LeoLHsu/Xenon_Lamp/Doc/Device/推杆.jpg

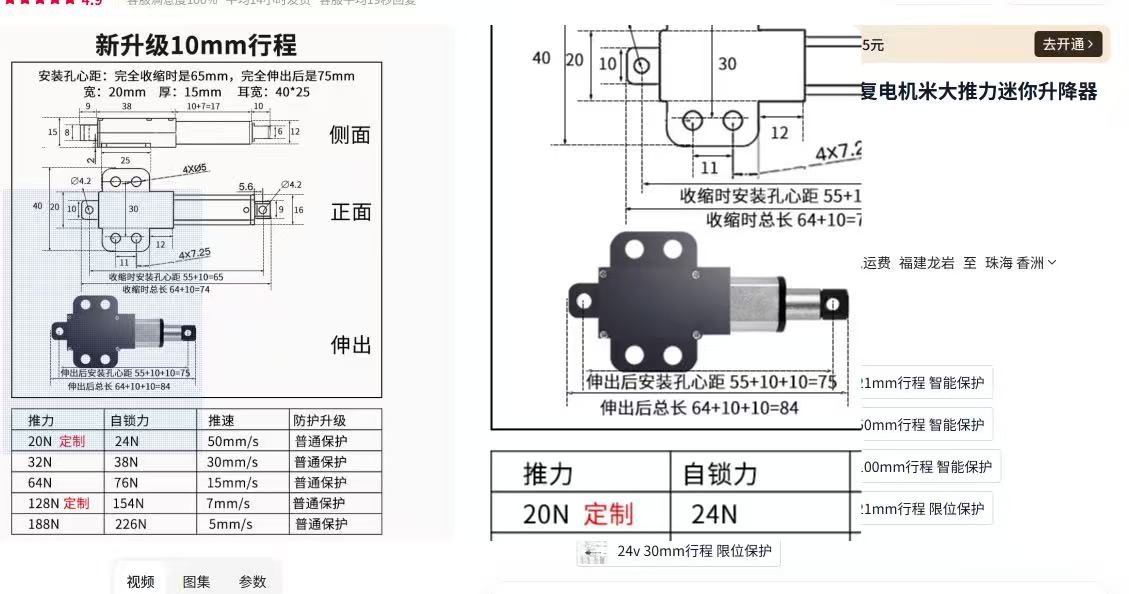
Doc/Device/推杆.jpg
