LeoLHsu/Xenon_Lamp/Doc/氙灯电源板功能描述.docx

功能描述：

1. 根据上位机的命令控制氙灯上电（LAMP_EN管脚，高有效）
2. 上电前需将电流设定调为最大10A（最大12A）,(重要，否则无法点亮氙灯)，点亮后再调低电流至目标亮度。
3. 电流设定信号为Current_SET管脚，MCU_DAC输出， Current_OUT=Current_SET/0.25
4. 电流检测信号为Current_DET管脚，MCU_DAC输入，

Current_DET=Current*0.25

5. 氙灯电压检测：Lamp_DET= Lamp_PWR/101

enable后，电压输出为150V.如电压持续10s不下降，则关闭电压输出，并报错：

1） 无电流输出，报错：触发器故障/输出空载
2） 有脉冲电流输出，报错：氙灯损坏

如氙灯可正常触发，电压应在3s秒迅速降低至8-15V，电流稳定至10A后，再根据亮度需求调整电流值。

电压超过17V，则应报错：氙灯寿命已接近耗尽

6. 寿命统计：400报错，500h强行关闭
7. 增加NTC功能，温度超过80度报警，100度强制关闭
