LeoLHsu/Xenon_Lamp/Doc/Sch/XL100A-60-01 A0.pdf

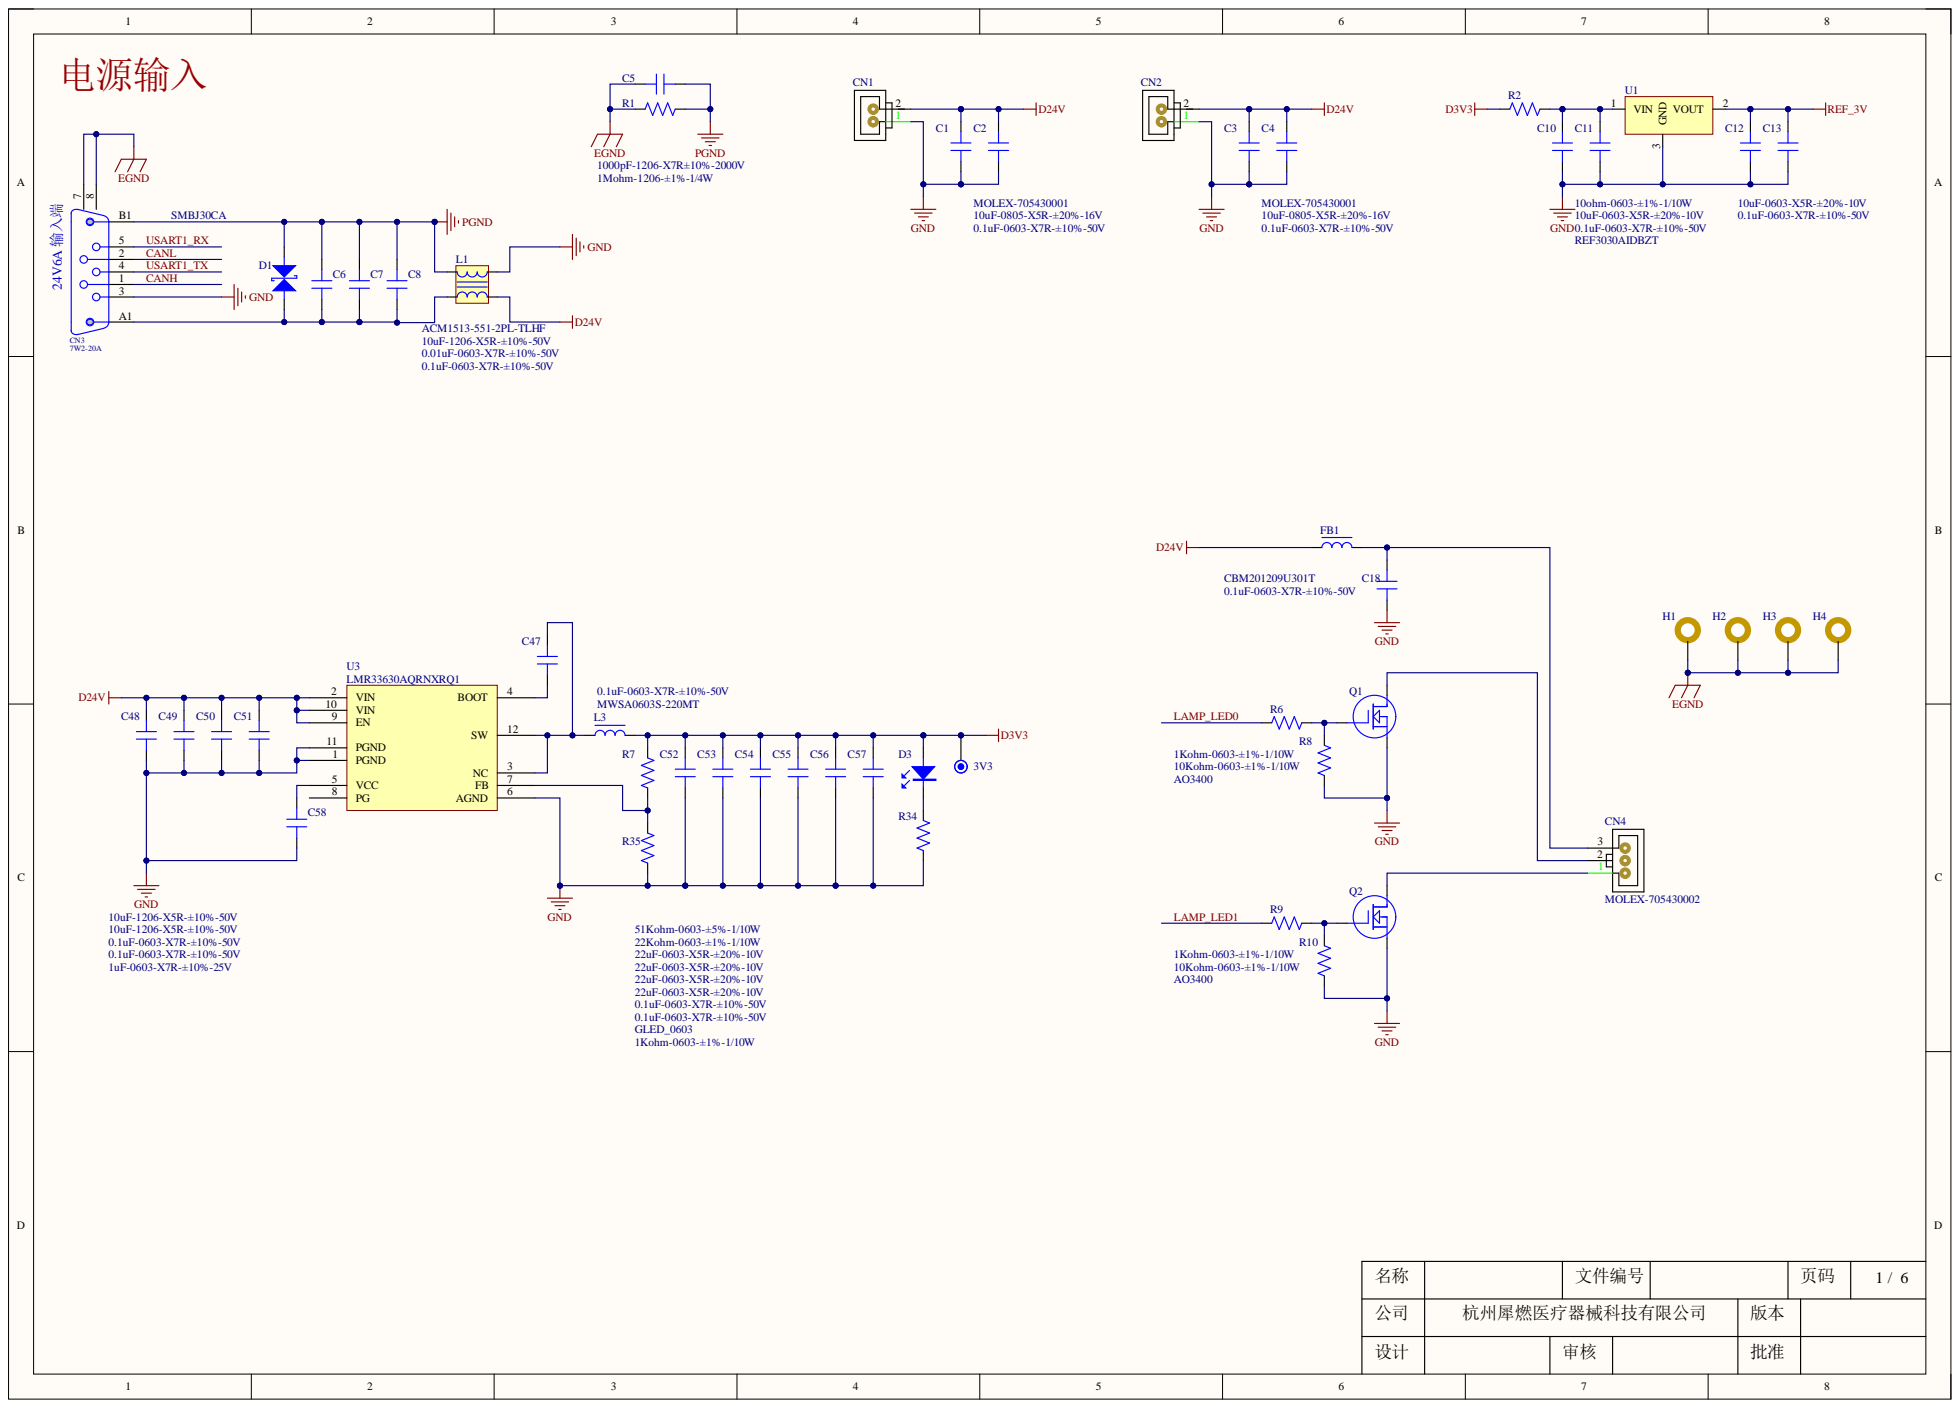
[picture p2: page 1]

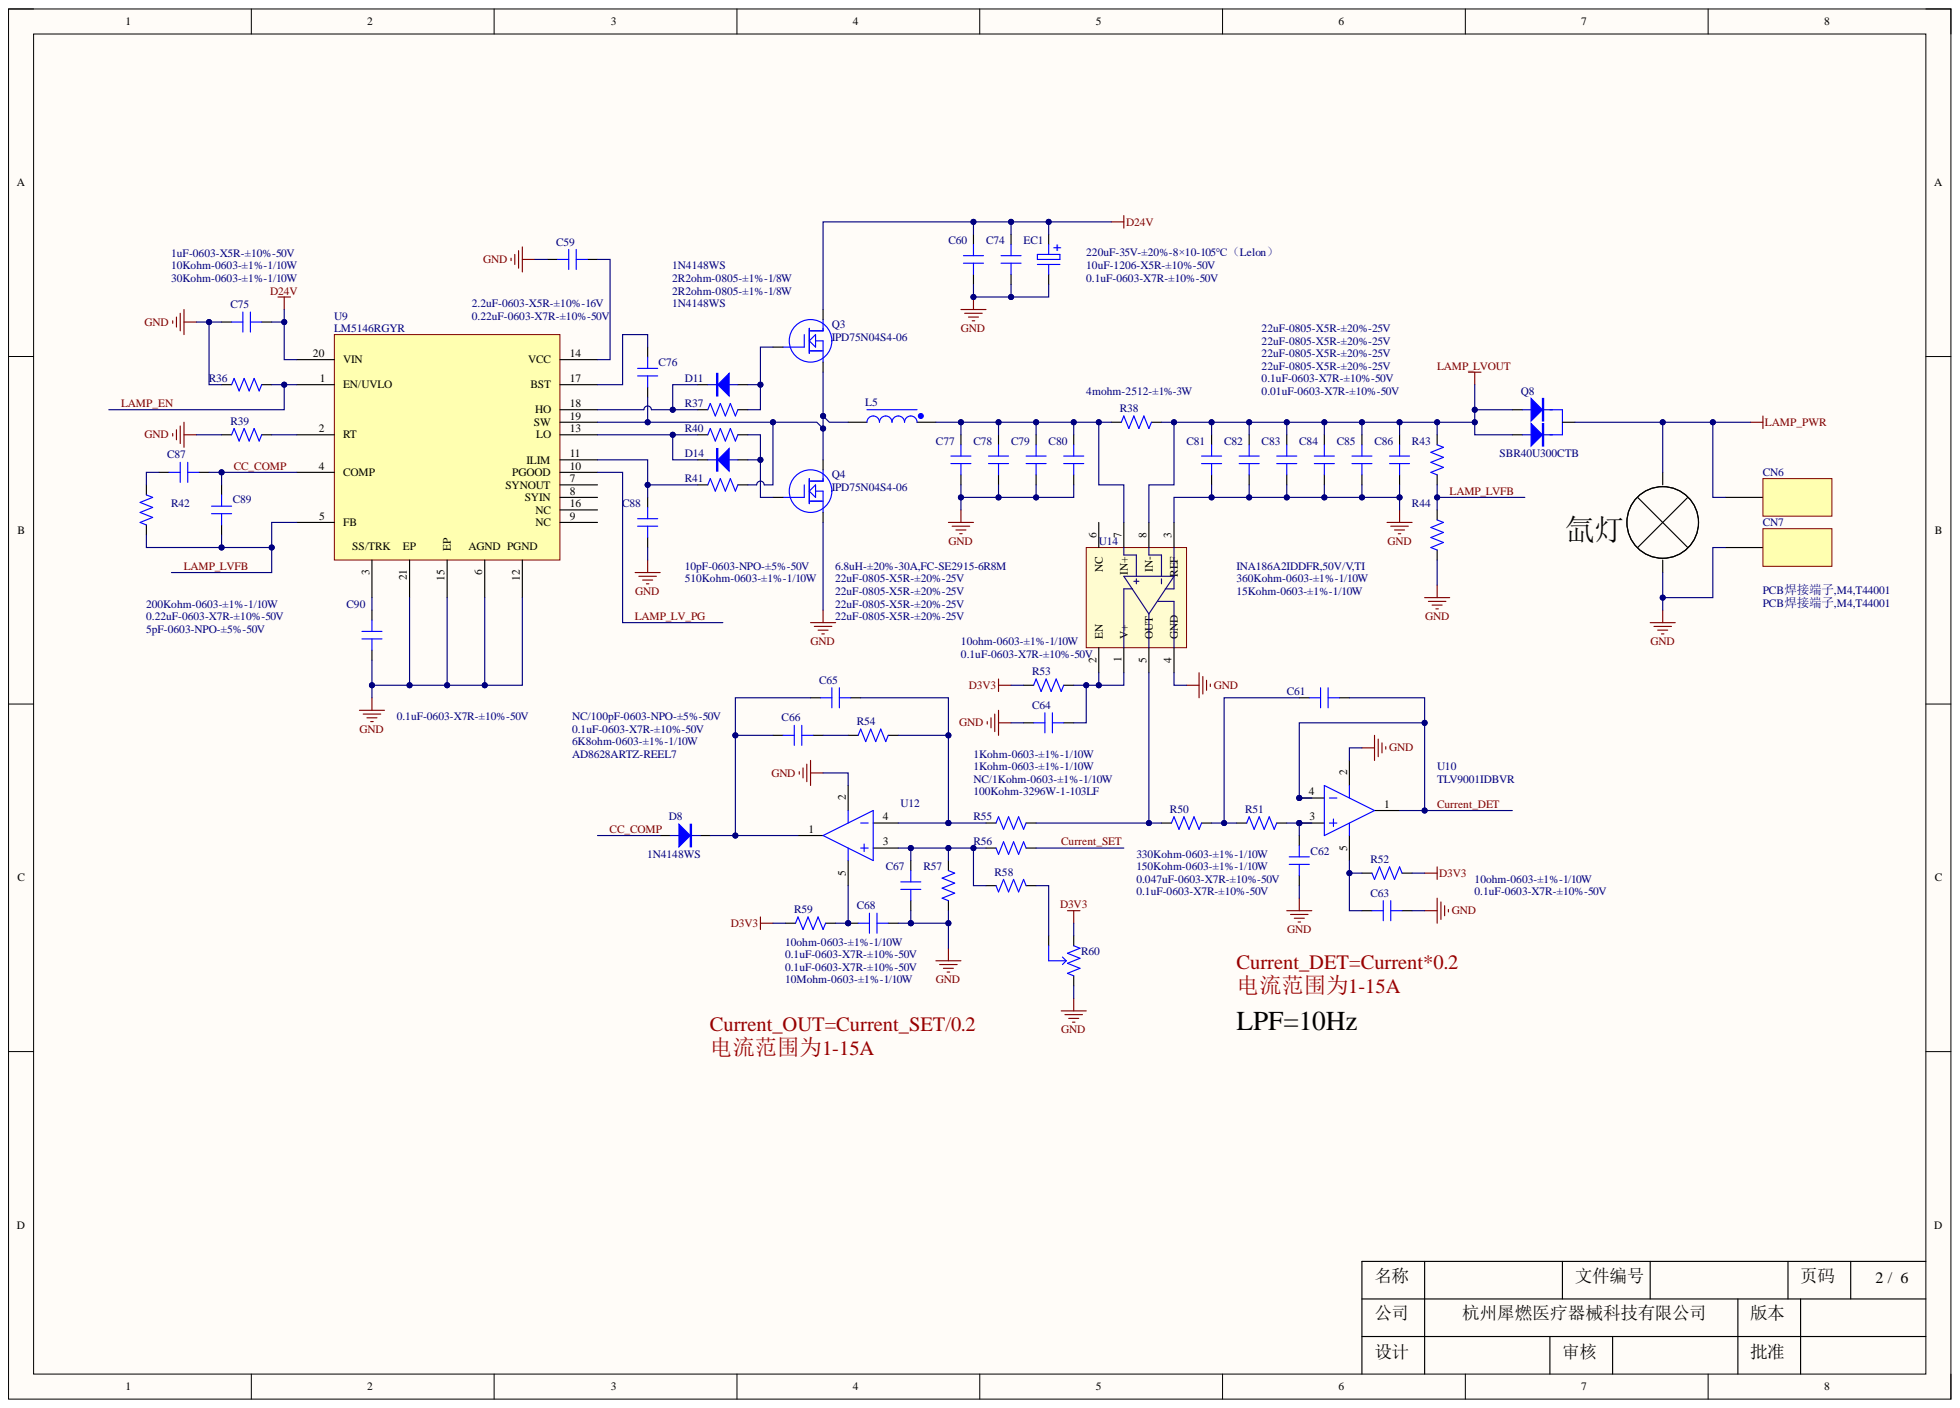
[picture p3: page 2]

7 | R41
8 | 510Kohm D

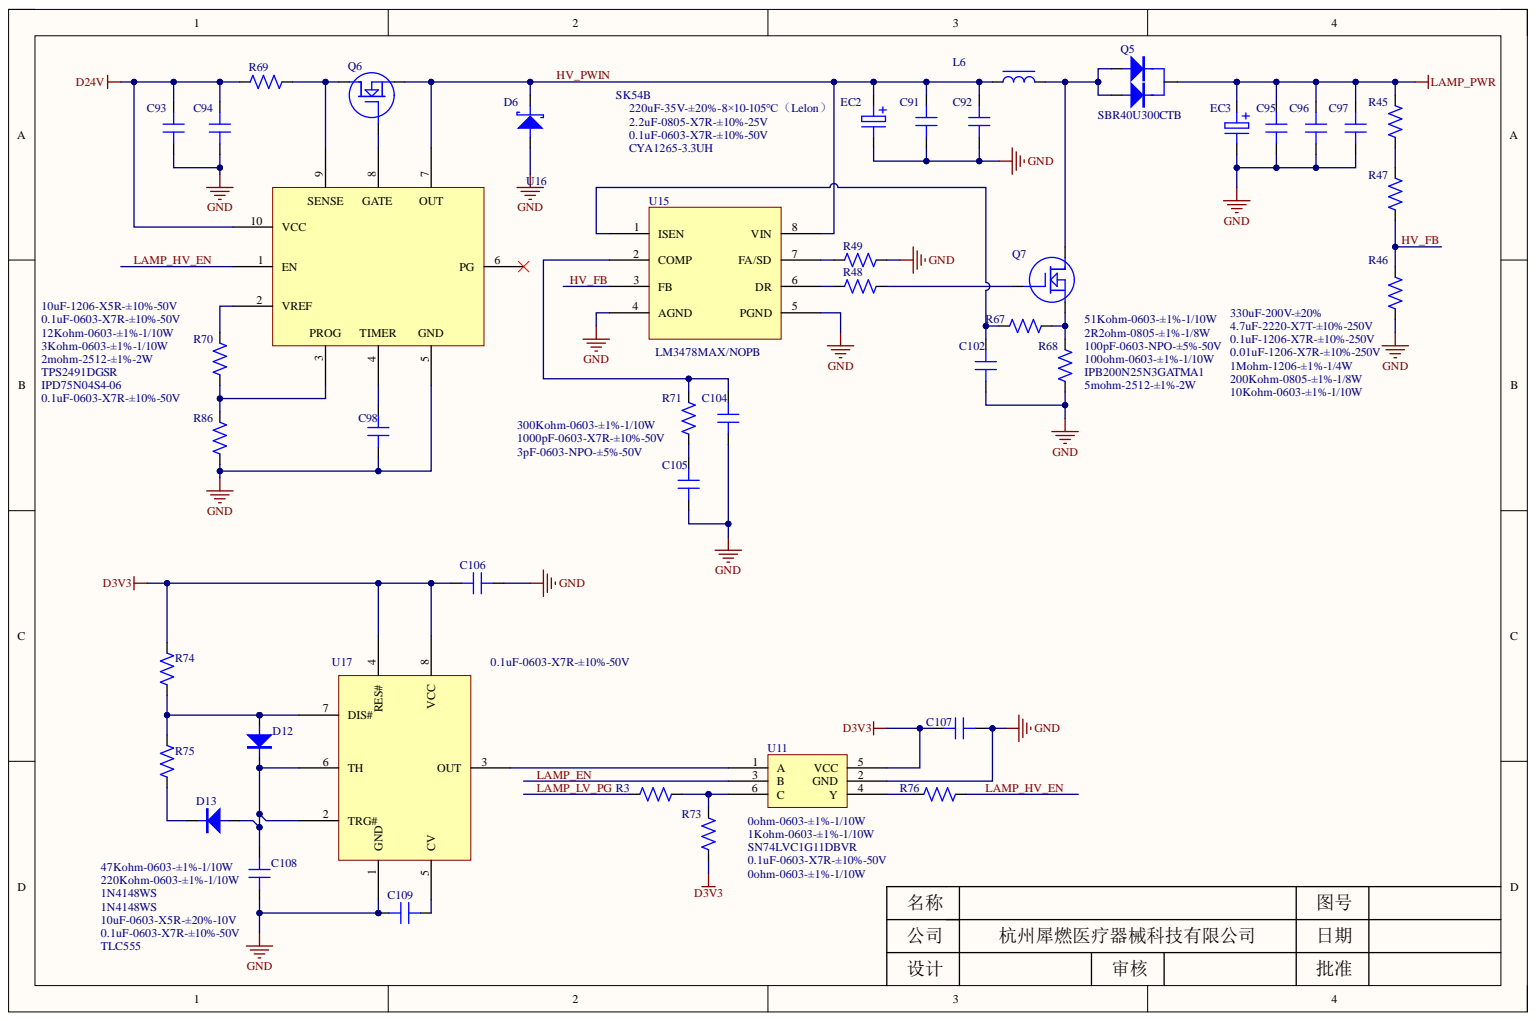
[picture p4: page 3]

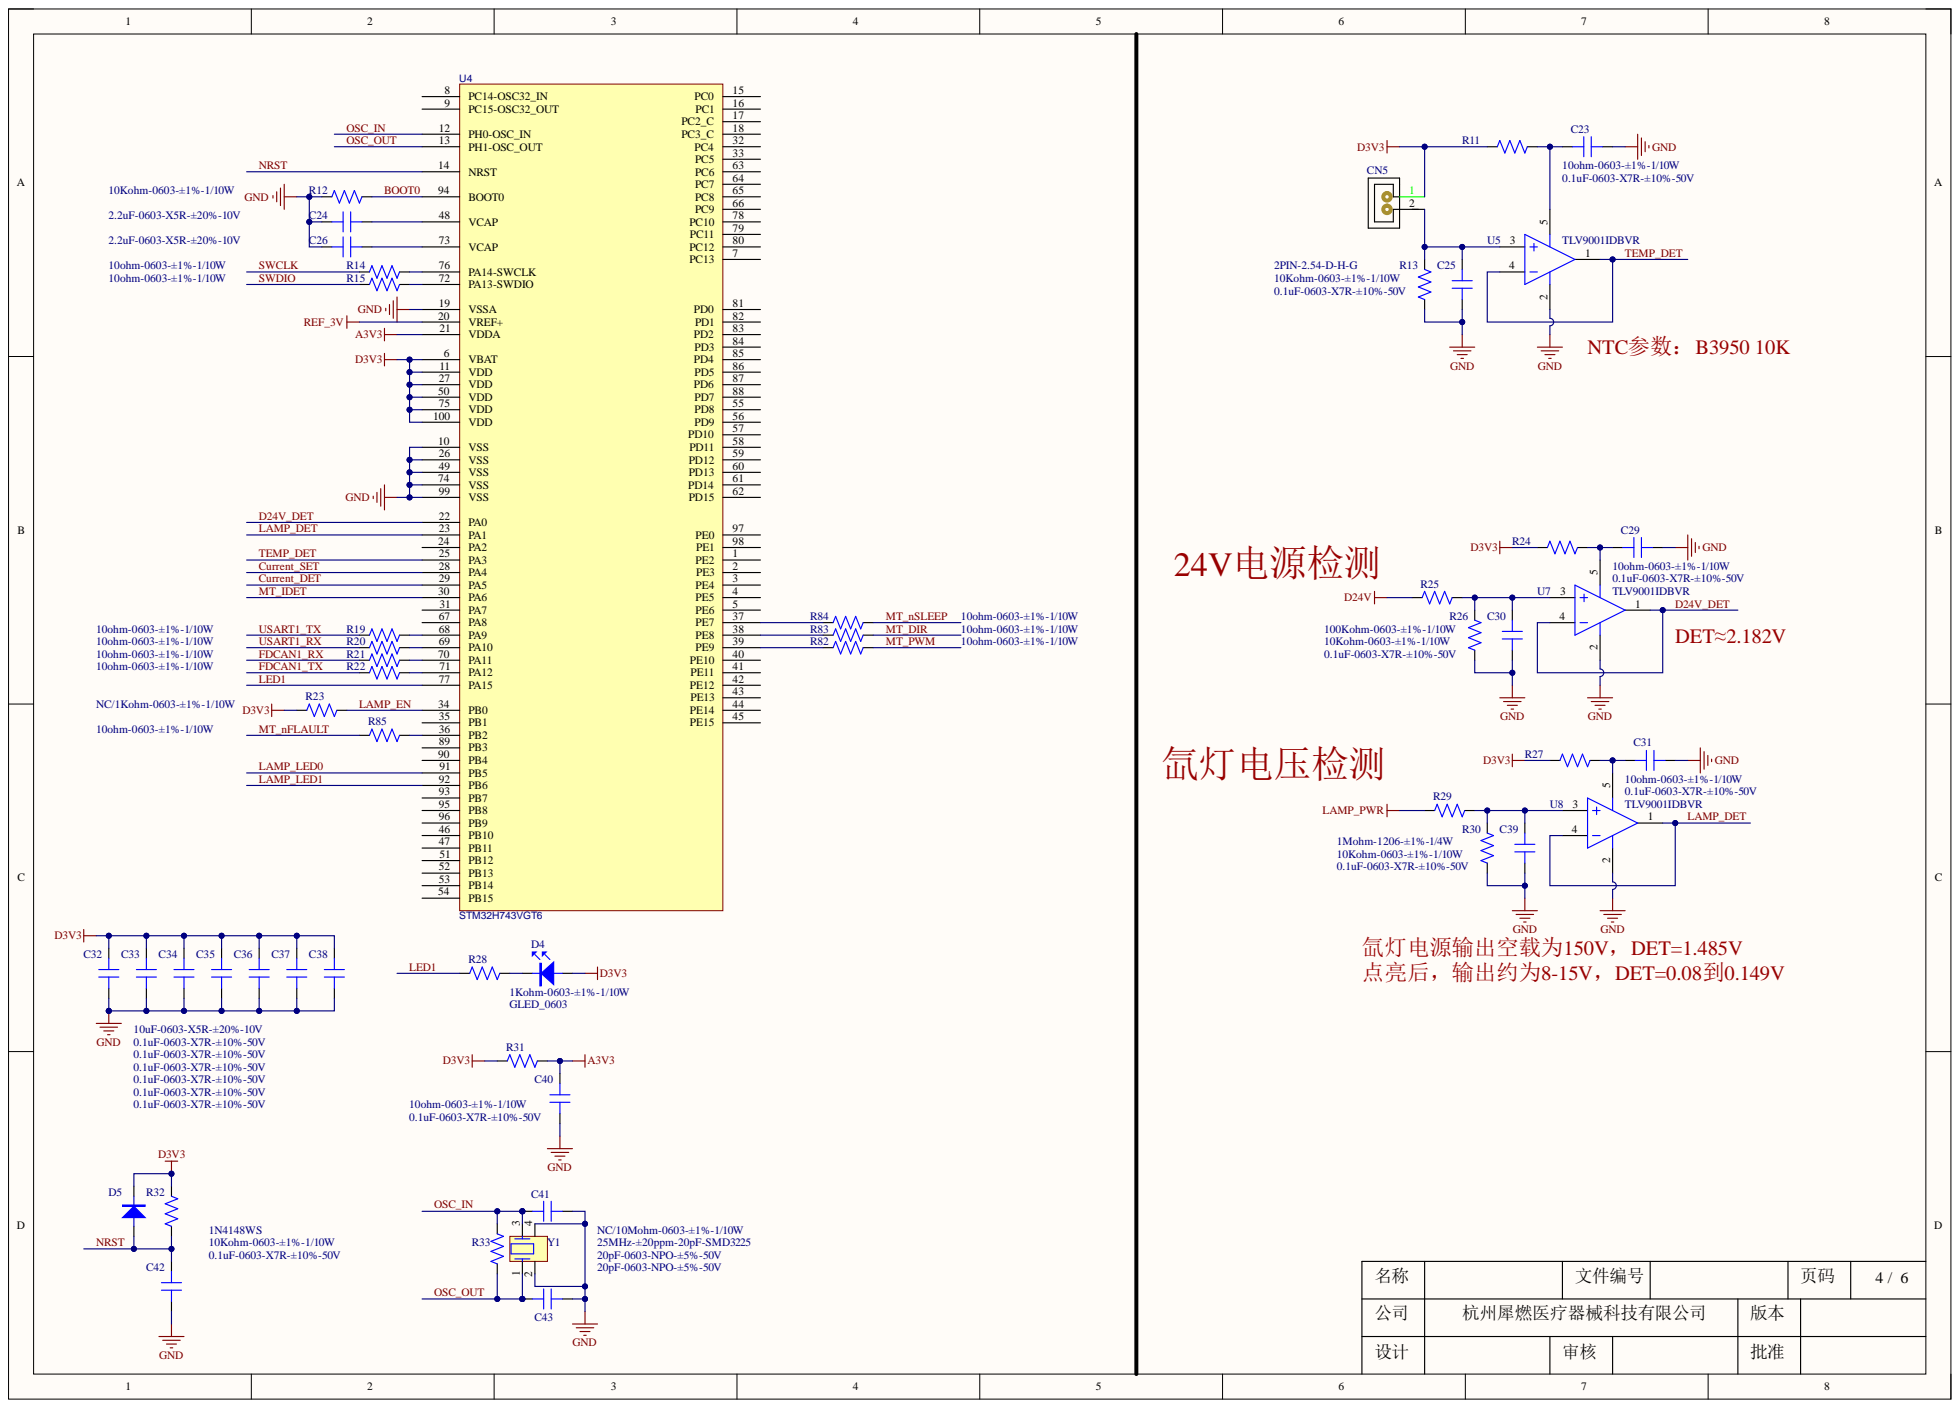
[picture p5: page 4]

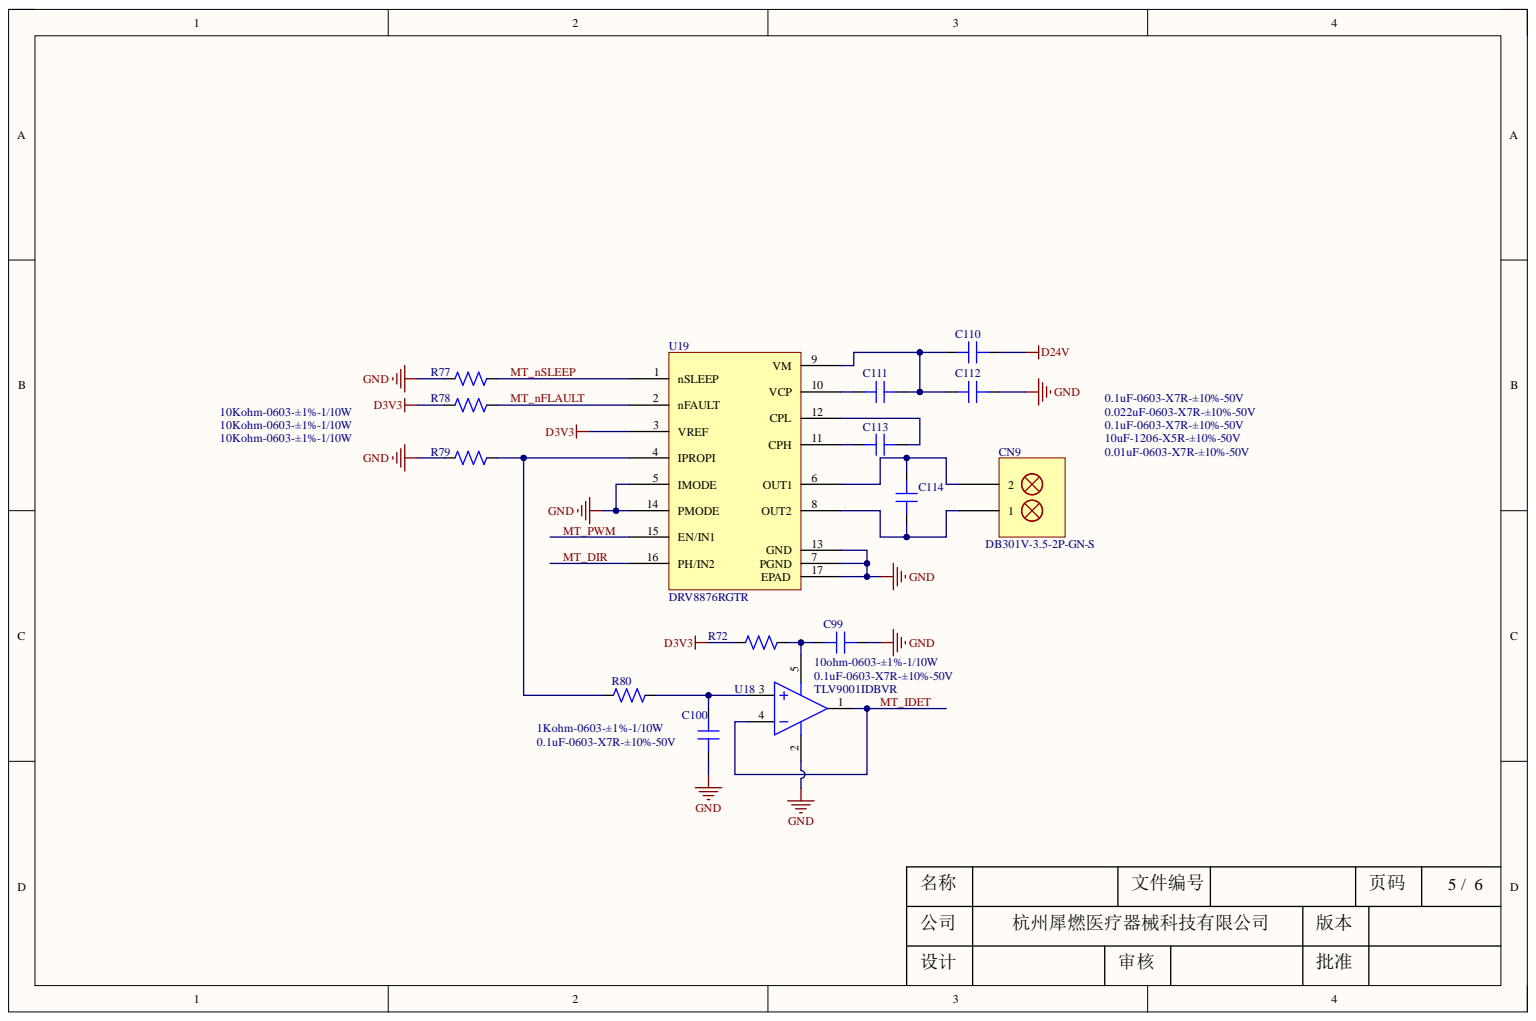
[picture p6: page 5]

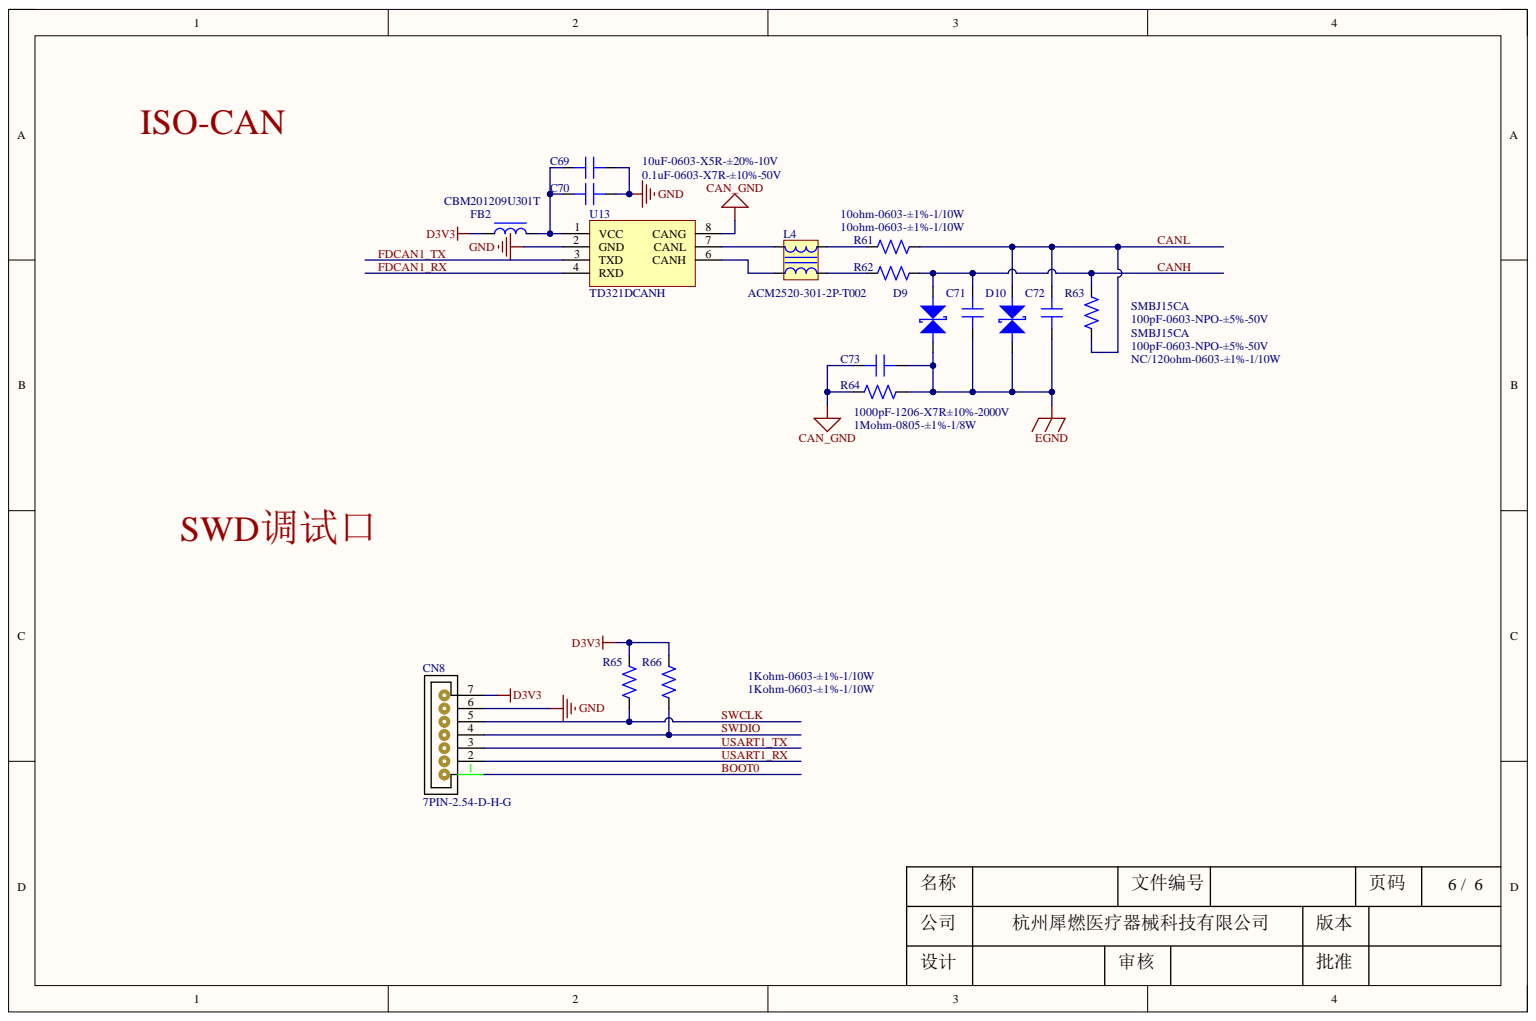
[picture p7: page 6]
