LeoLHsu/Xenon_Lamp/Core/Src/main.c

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
/* Includes ------------------------------------------------------------------*/
#include "main.h"
#include "adc.h"
#include "dac.h"
#include "dma.h"
#include "fdcan.h"
#include "iwdg.h"
#include "usart.h"
#include "gpio.h"

/* USER CODE BEGIN Includes */
#include <string.h>
#include "Can_Service.h"
#include "UserPref.h"
#include "drv8876.h"
#include "Xenon_Lamp.h"
/* USER CODE END Includes */


void SystemClock_Config(void);
void PeriphCommonClock_Config(void);
static void MPU_Config(void);
/* USER CODE BEGIN 0 */
#ifdef BOOTLOADER

/** @brief  Vector base address configuration. It should no longer be at the start of
  *         flash memory but moved forward because the first part of flash is
  *         reserved for the bootloader. Note that this is already done by the
  *         bootloader before starting this program. Unfortunately, function
  *         SystemInit() overwrites this change again.
  * @return none.
  */
static void VectorBase_Config(void)
{
    /* The constant array with vectors of the vector table is declared externally in the
     * c-startup code.
     */
    extern const unsigned long g_pfnVectors[];

    /* Remap the vector table to where the vector table is located for this program. */
    SCB->VTOR = (unsigned long)&g_pfnVectors[0];
}
#endif
/* USER CODE END 0 */

/**
  * @brief  The application entry point.
  * @retval int
  */
int main(void)
{
    /* USER CODE BEGIN 1 */
#ifdef BOOTLOADER
    /* Configure the vector table base address. */
    VectorBase_Config();
#endif
    /* USER CODE END 1 */

    /* MPU Configuration--------------------------------------------------------*/
    MPU_Config();

    /* Enable I-Cache---------------------------------------------------------*/
    SCB_EnableICache();

    /* Enable D-Cache---------------------------------------------------------*/
    SCB_EnableDCache();

    /* MCU Configuration--------------------------------------------------------*/

    /* Reset of all peripherals, Initializes the Flash interface and the Systick. */
    HAL_Init();

    /* Configure the system clock */
    SystemClock_Config();

    /* Configure the peripherals common clocks */
    PeriphCommonClock_Config();

    /* Initialize all configured peripherals */
    MX_GPIO_Init();
    MX_DMA_Init();
    MX_USART1_UART_Init();
    MX_DAC1_Init();
    MX_FDCAN1_Init();
    MX_ADC1_Init();
    MX_IWDG1_Init();
    /* USER CODE BEGIN 2 */
    SystemTimeBase_Initial();
    Debug_Initial();
    CAN_Initial();
    MainReg_Initial();
    /* USER CODE END 2 */

    /* Infinite loop */
    /* USER CODE BEGIN WHILE */
    EE_Read_Setting();
    DRV8876_Init();
    Xenon_Lamp_Initial();
    while (1) {
        /* USER CODE END WHILE */

        /* USER CODE BEGIN 3 */
        HAL_IWDG_Refresh(&hiwdg1);
        SystemTimeBase_Set_Handler();
        CAN_Handler();
        Debug_Handler();
        Adc_Handler();
        Xenon_Lamp_Service();
        EE_Setting_Handler();
        SystemTimeBase_Clr_Handler();
    }
    /* USER CODE END 3 */
}

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
/* MPU Configuration */

void MPU_Config(void)
{
    MPU_Region_InitTypeDef MPU_InitStruct = {0};

    /* Disables the MPU */
    HAL_MPU_Disable();

    /** Initializes and configures the Region and the memory to be protected
    */
    MPU_InitStruct.Enable = MPU_REGION_ENABLE;
    MPU_InitStruct.Number = MPU_REGION_NUMBER0;
    MPU_InitStruct.BaseAddress = 0x24000000;
    MPU_InitStruct.Size = MPU_REGION_SIZE_512KB;
    MPU_InitStruct.SubRegionDisable = 0x0;
    MPU_InitStruct.TypeExtField = MPU_TEX_LEVEL0;
    MPU_InitStruct.AccessPermission = MPU_REGION_FULL_ACCESS;
    MPU_InitStruct.DisableExec = MPU_INSTRUCTION_ACCESS_ENABLE;
    MPU_InitStruct.IsShareable = MPU_ACCESS_NOT_SHAREABLE;
    MPU_InitStruct.IsCacheable = MPU_ACCESS_NOT_CACHEABLE;
    MPU_InitStruct.IsBufferable = MPU_ACCESS_NOT_BUFFERABLE;

    HAL_MPU_ConfigRegion(&MPU_InitStruct);
    /* Enables the MPU */
    HAL_MPU_Enable(MPU_PRIVILEGED_DEFAULT);

}

/**
  * @brief  This function is executed in case of error occurrence.
  * @retval None
  */
void Error_Handler(void)
{
    /* USER CODE BEGIN Error_Handler_Debug */
    /* User can add his own implementation to report the HAL error return state */
    __disable_irq();
    while (1) {
    }
    /* USER CODE END Error_Handler_Debug */
}

#ifdef  USE_FULL_ASSERT
/**
  * @brief  Reports the name of the source file and the source line number
  *         where the assert_param error has occurred.
  * @param  file: pointer to the source file name
  * @param  line: assert_param error line source number
  * @retval None
  */
void assert_failed(uint8_t *file, uint32_t line)
{
    /* USER CODE BEGIN 6 */
    /* User can add his own implementation to report the file name and line number,
       ex: printf("Wrong parameters value: file %s on line %d\r\n", file, line) */
    /* USER CODE END 6 */
}
#endif /* USE_FULL_ASSERT */
