LeoLHsu/Xenon_Lamp/Xenon_Lamp.ioc

Mcu.UserName=STM32H743VGTx
PA0.GPIO_Label=ADC_CH0_D24V
PA0.Signal=ADC1_INP16
PA1.GPIO_Label=ADC_CH1_LAMP_VOL
PA1.Signal=ADC1_INP17
PA10.GPIO_Label=UART_DEBUG_RX
PA10.Signal=USART1_RX
PA11.GPIO_Label=CAN_HOST_RX
PA11.Signal=FDCAN1_RX
PA12.GPIO_Label=CAN_HOST_TX
PA12.Signal=FDCAN1_TX
PA3.GPIO_Label=ADC_CH2_TEMP
PA3.Signal=ADCx_INP15
PA4.GPIO_Label=DAC_CH0_LAMP_SET
PA4.Signal=COMP_DAC11_group
PA5.GPIO_Label=ADC_CH3_LAMP_CURR
PA5.Signal=ADCx_INP19
PA6.GPIO_Label=ADC_CH4_MOTOR_CURR
PA6.Signal=ADCx_INP3
PA9.GPIO_Label=UART_DEBUG_TX
PA9.Signal=USART1_TX
PB0.GPIO_Label=LAMP_EN
PB0.Signal=GPIO_Output
PB2.GPIO_Label=MOTOR_nFAULT
PB2.Signal=GPIO_Input
PB5.GPIO_Label=LAMP_IND_LED0
PB5.Signal=GPIO_Output
PB6.GPIO_Label=LAMP_IND_LED1
PB6.Signal=GPIO_Output
PE7.GPIO_Label=MOTOR_nSLEEP
PE7.Signal=GPIO_Output
PE8.GPIO_Label=MOTOR_PH
PE8.Signal=GPIO_Output
PE9.GPIO_Label=MOTOR_EN
PE9.Signal=GPIO_Output
