LeoLHsu/Xenon_Lamp/Core/Inc/main.h

#define BOOT_FLASH_APP_MARKER_OFFSET        0x20034     // 128K(Bootloader) + 0x32(Offset)
#define ADC_CH0_D24V_Pin GPIO_PIN_0
#define ADC_CH0_D24V_GPIO_Port GPIOA
#define ADC_CH1_LAMP_VOL_Pin GPIO_PIN_1
#define ADC_CH1_LAMP_VOL_GPIO_Port GPIOA
#define ADC_CH2_TEMP_Pin GPIO_PIN_3
#define ADC_CH2_TEMP_GPIO_Port GPIOA
#define DAC_CH0_LAMP_SET_Pin GPIO_PIN_4
#define DAC_CH0_LAMP_SET_GPIO_Port GPIOA
#define ADC_CH3_LAMP_CURR_Pin GPIO_PIN_5
#define ADC_CH3_LAMP_CURR_GPIO_Port GPIOA
#define ADC_CH4_MOTOR_CURR_Pin GPIO_PIN_6
#define ADC_CH4_MOTOR_CURR_GPIO_Port GPIOA
#define LAMP_EN_Pin GPIO_PIN_0
#define LAMP_EN_GPIO_Port GPIOB
#define MOTOR_nFAULT_Pin GPIO_PIN_2
#define MOTOR_nFAULT_GPIO_Port GPIOB
#define MOTOR_nSLEEP_Pin GPIO_PIN_7
#define MOTOR_nSLEEP_GPIO_Port GPIOE
#define MOTOR_PH_Pin GPIO_PIN_8
#define MOTOR_PH_GPIO_Port GPIOE
#define MOTOR_EN_Pin GPIO_PIN_9
#define MOTOR_EN_GPIO_Port GPIOE
#define UART_DEBUG_TX_Pin GPIO_PIN_9
#define UART_DEBUG_TX_GPIO_Port GPIOA
#define UART_DEBUG_RX_Pin GPIO_PIN_10
#define UART_DEBUG_RX_GPIO_Port GPIOA
#define CAN_HOST_RX_Pin GPIO_PIN_11
#define CAN_HOST_RX_GPIO_Port GPIOA
#define CAN_HOST_TX_Pin GPIO_PIN_12
#define CAN_HOST_TX_GPIO_Port GPIOA
#define LED_Pin GPIO_PIN_15
#define LED_GPIO_Port GPIOA
#define LAMP_IND_LED0_Pin GPIO_PIN_5
#define LAMP_IND_LED0_GPIO_Port GPIOB
#define LAMP_IND_LED1_Pin GPIO_PIN_6
#define LAMP_IND_LED1_GPIO_Port GPIOB
