LeoLHsu/Xenon_Lamp/Service/Xenon_Lamp.c

#include "Xenon_Lamp.h"
#include "MainRegister.h"
#include "Adc_Service.h"
#include "dac.h"
#include "UserPref.h"
#include "drv8876.h"
#include <stdlib.h>
#include <math.h>

uint8_t XenonLampFilterReset;
uint8_t XenonLampFilterSetPre;

Xenon_Ctrl_Step_t XenonLampCtrlStep = ESTABLISH_CURR;
uint16_t XenonLampCtrlTimer = 0;
int16_t XenonLampCtrlCnt = 0;

float XenonLampVol = 0.f;
float XenonLampCurrSet = 0.f;
float XenonLampCurr = 0.f;
float XenonLampTemp = 0.f;

uint32_t XenonLampWorkTimer_1s;
uint32_t XenonLampWorkTimer_Min;

static IlluminationPara_t Illumination[21] = {       /* Illumination at 8mm photosensitive surface and 5mm distance */
    {0,     0       },
    {5,     0       },
    {10,    0       },
    {15,    0       },
    {20,    0       },
    {25,    0       },
    {30,    0       },
    {35,    45500   },
    {40,    60500   },
    {45,    78000   },
    {50,    95500   },
    {55,    114500  },
    {60,    133500  },
    {65,    154375  },
    {70,    175250  },
    {75,    196625  },
    {80,    218000  },
    {85,    240750  },
    {90,    263500  },
    {95,    283000  },
    {100,   302500  },
};

void Set_Xenon_Lamp_IncLED(uint8_t newState)
{
    HAL_GPIO_WritePin(LAMP_IND_LED0_GPIO_Port, LAMP_IND_LED0_Pin, !!newState);
}

void Set_Xenon_Lamp_Enable(uint8_t newState)
{
    HAL_GPIO_WritePin(LAMP_EN_GPIO_Port, LAMP_EN_Pin, !!newState);
}

void Set_Xenon_Lamp_Curr(float newCurr)
{
    uint16_t newDacValue;

    if (fabs(newCurr) < 1e-6) {
        newDacValue = 0;
    } else {
        newDacValue = newCurr / XENON_LAMP_CONTROLER_CURR_MAX * XENON_LAMP_CONTROLER_DAC_MAX;
    }

    HAL_DAC_SetValue(&hdac1, DAC_CHANNEL_1, DAC_ALIGN_12B_R, newDacValue);
}

int8_t Set_Xenon_Lamp_Illumination(uint16_t percentage)
{
    float duty = 0, setIrradiance = 0;

    if (percentage > R_BRIGHTNESS_SET_MAX) {
        percentage = R_BRIGHTNESS_SET_MAX;
    }

#ifdef USE_LINEAR_ILLUMINATION
    uint8_t lower = 0, upper = 0;
    int8_t i = 0, j = 0;

    for (i = 0; i <= 21; i++) {
        if (Illumination[i].value != 0) {
            lower = i;
            break;
        }
    }
    for (j = 21; j >= 0; j--) {
        if (Illumination[j].value != 0) {
            upper = j;
            break;
        }
    }

    if ((i > 21) || (j < 0) || (upper < lower)) {
        return -1;
    } else {
        if (percentage == 0) {
            duty = Illumination[lower].duty;
        } else if (percentage == 100) {
            duty = Illumination[upper].duty;
        } else {
            setIrradiance = (float)percentage / 100 * Illumination[upper].value;
            if (setIrradiance < Illumination[lower].value) {
                duty = Illumination[lower].duty;
            } else {
                for (i = lower; i <= upper; i++) {
                    if ((setIrradiance >= Illumination[i].value) && (setIrradiance < Illumination[i + 1].value)) {
                        duty = Illumination[i].duty;
                        duty += (setIrradiance - Illumination[i].value) /
                                (Illumination[i + 1].value - Illumination[i].value) *
                                (Illumination[i + 1].duty - Illumination[i].duty);
                        break;
                    }
                }
            }
        }
    }
#else
    (void)(setIrradiance);
    (void)(Illumination);
    duty = percentage;
#endif

    Set_Xenon_Lamp_Curr(duty / R_BRIGHTNESS_SET_MAX * XENON_LAMP_CURR_MAX);
    return 0;
}

void Xenon_Lamp_Initial(void)
{
    // SET_BIT(R_ENABLE, XENON_LAMP_ENABLE);
    R_LIGHT_FILTER_SET = XenonLampFilterSetPre = 0;
    R_LIGHT_FILTER_CURR = 0;
    XenonLampFilterReset = 1;

    R_BRIGHTNESS_SET = 0;
    R_LIGHT_WORK_HOUR_RESET = 0;
    XenonLampWorkTimer_1s = 0;
    XenonLampWorkTimer_Min = UserSettingLampWorkTimerMin;
    R_LIGHT_WORK_HOUR = UserSettingLampWorkTimerMin / 60;
    R_LIGHT_LIFE_HOUR = UserSettingLampLifeTimeHr;
    R_ERROR_REPORT_TIMEBASE = 30;
}

void Xenon_Lamp_Service(void)
{
    static uint16_t brightnessSet_Pre = 0;

    if (__HAL_RCC_GET_PLL_OSCSOURCE() != RCC_PLLSOURCE_HSE) {
        CLEAR_BIT(R_ENABLE, XENON_LAMP_ENABLE);
        ModuleError.bits.externalOsc = 1;
    } else {
        ModuleError.bits.externalOsc = 0;
    }

    if (READ_BIT(R_ENABLE, XENON_LAMP_ENABLE)) {
        if (SYS_TIM_FLAG_100MS) {
            DRV8876_GetStatus();
            ModuleError.bits.filterMotor = !!motor_status.fault;

            if (motor_status.fault == 0) {
                if (XenonLampFilterReset) {
                    R_LIGHT_FILTER_SET = 0;
                    R_LIGHT_FILTER_CURR = 0;
                    XenonLampFilterSetPre = 1;
                    XenonLampFilterReset = 0;
                }
                if (XenonLampFilterSetPre != R_LIGHT_FILTER_SET) {
                    XenonLampFilterSetPre = R_LIGHT_FILTER_SET;
                    if (XenonLampFilterSetPre) {
                        DRV8876_SetStatus(MOTOR_FORWARD);
                    } else {
                        DRV8876_SetStatus(MOTOR_REVERSE);
                    }
                } else {
                    if (motor_status.current <= 1e-6) {
                        DRV8876_SetStatus(MOTOR_STOP);
                        R_LIGHT_FILTER_CURR = R_LIGHT_FILTER_SET;
                    }
                }
            } else {
                DRV8876_SetStatus(MOTOR_STOP);
            }

            XenonLampVol = (float)ADC1FilterResult[ADC1_RANK_LMAP_VOL] * ADC_DAC_VEF_VOL / 65535 * 101;
            XenonLampCurr = (float)ADC1FilterResult[ADC1_RANK_LMAP_CURR] * ADC_DAC_VEF_VOL / 65535 / 0.25;
            XenonLampTemp = Calculate_Temperature(ADC1FilterResult[ADC1_RANK_TEMP]);

            if (R_BRIGHTNESS_SET) {
                if (XenonLampTemp >= XENON_LAMP_SHOTDOWN_TMEP) {
                    ModuleError.bits.lightTemp = 0;
                    ModuleError.bits.lightTempShotdown = 1;
                } else if (XenonLampTemp >= XENON_LAMP_ERROR_TMEP) {
                    ModuleError.bits.lightTemp = 1;
                    ModuleError.bits.lightTempShotdown = 0;
                } else {
                    ModuleError.bits.lightTemp = 0;
                    ModuleError.bits.lightTempShotdown = 0;
                }
                if (R_LIGHT_WORK_HOUR >= R_LIGHT_LIFE_HOUR) {
                    ModuleError.bits.lightLife = 0;
                    ModuleError.bits.lightLifeShotdown = 1;
                } else if (R_LIGHT_WORK_HOUR >= (uint16_t)(R_LIGHT_LIFE_HOUR * XENON_LAMP_SHOTDOWN_LIFE_FACTOR)) {
                    ModuleError.bits.lightLife = 1;
                    ModuleError.bits.lightLifeShotdown = 0;
                } else {
                    ModuleError.bits.lightLife = 0;
                    ModuleError.bits.lightLifeShotdown = 0;
                }
            } else {
                ModuleError.bits.lightTemp = 0;
                ModuleError.bits.lightTempShotdown = 0;
                ModuleError.bits.lightLife = 0;
                ModuleError.bits.lightLifeShotdown = 0;
            }

            if (ModuleError.bits.lightTempShotdown || ModuleError.bits.lightLifeShotdown) {
                XenonLampCtrlStep = SHOTDOWN;
            }

            if (R_BRIGHTNESS_SET) {
                switch (XenonLampCtrlStep) {
                    case ESTABLISH_CURR:
                        Set_Xenon_Lamp_Curr(XENON_LAMP_START_CURR);
                        XenonLampCtrlStep = DRIVE_ENABLE;
                        brightnessSet_Pre = 100;
                        break;
                    case DRIVE_ENABLE:
                        Set_Xenon_Lamp_Enable(ON);
                        XenonLampCtrlTimer = 100;
                        XenonLampCtrlCnt = 0;
                        XenonLampCtrlStep = WAITING_LIGHT_UP;
                        break;
                    case WAITING_LIGHT_UP:
                        if (XenonLampCtrlTimer) {
                            XenonLampCtrlTimer--;
                            if ((fabs(XenonLampVol) > 1e-6) && (XenonLampVol < XENON_LAMP_LIFE_IND_VOL) && \
                                    (fabs(XenonLampCurr - XENON_LAMP_START_CURR) < (XENON_LAMP_START_CURR * 10 / 100))) {
                                if (++XenonLampCtrlCnt > 2) {
                                    XenonLampCtrlCnt = 0;
                                    XenonLampCtrlTimer = 0;
                                    XenonLampCtrlStep = DIMMING;
                                }
                            } else {
                                XenonLampCtrlCnt = 0;
                            }
                        } else {
                            XenonLampCtrlStep = TURN_ON_FAILED;
                            ModuleError.bits.lightDamage = 1;
                        }
                        break;
                    case DIMMING:
                        if (abs(brightnessSet_Pre - R_BRIGHTNESS_SET) > 2) {
                            if (brightnessSet_Pre > R_BRIGHTNESS_SET) {
                                brightnessSet_Pre -= 2;
                            } else {
                                brightnessSet_Pre += 2;
                            }
                        } else {
                            brightnessSet_Pre = R_BRIGHTNESS_SET;
                        }
                        if (0 != Set_Xenon_Lamp_Illumination(brightnessSet_Pre)) {
                            XenonLampCtrlStep = TURN_ON_FAILED;
                        }
                        if (XenonLampVol > XENON_LAMP_LIFE_IND_VOL) {
                            if (XenonLampCtrlCnt < 0) {
                                XenonLampCtrlCnt = 0;
                            }
                            if (++XenonLampCtrlCnt > 100) {
                                XenonLampCtrlCnt = 100;
                                ModuleError.bits.lightHardwareLife = 1;
                            }
                        } else {
                            if (XenonLampCtrlCnt > 0) {
                                XenonLampCtrlCnt = 0;
                            }
                            if (--XenonLampCtrlCnt < -100) {
                                XenonLampCtrlCnt = -100;
                                ModuleError.bits.lightHardwareLife = 0;
                            }
                        }
                        break;
                    case TURN_ON_FAILED:
                    case SHOTDOWN:
                        R_BRIGHTNESS_SET = 0;
                        Set_Xenon_Lamp_Enable(OFF);
                        Set_Xenon_Lamp_Curr(0);
                        break;
                    default:
                        break;
                }
            } else {
                XenonLampCtrlStep = ESTABLISH_CURR;
                Set_Xenon_Lamp_Enable(OFF);
                Set_Xenon_Lamp_Curr(0);

                ModuleError.bits.lightDamage = 0;
            }
#ifdef XENON_PRINT
            printf("SP %d, %d, %.2f, %.2f, %.2f\n", R_BRIGHTNESS_SET, XenonLampCtrlStep, XenonLampVol, XenonLampCurr, XenonLampTemp);
            // printf("SP %d, %d, %d, %.2f\n", motor_status.enabled, motor_status.direction, motor_status.fault, motor_status.current);
#endif
        }
    } else {
        DRV8876_SetStatus(MOTOR_STOP);
        R_LIGHT_FILTER_SET = XenonLampFilterSetPre;
        R_LIGHT_FILTER_CURR = XenonLampFilterSetPre;

        XenonLampCtrlStep = ESTABLISH_CURR;
        Set_Xenon_Lamp_Enable(OFF);
        Set_Xenon_Lamp_Curr(0);
        R_BRIGHTNESS_SET = 0;
        R_BRIGHTNESS_CURR = 0;
    }

    if (XenonLampCtrlStep == DIMMING) {
        Set_Xenon_Lamp_IncLED(ON);
    } else {
        Set_Xenon_Lamp_IncLED(OFF);
    }

    if (SYS_TIM_FLAG_500MS) {
        HAL_GPIO_TogglePin(LED_GPIO_Port, LED_Pin);
    }

    if (SYS_TIM_FLAG_1000MS) {
        if (R_LIGHT_WORK_HOUR_RESET) {
            R_LIGHT_WORK_HOUR_RESET = 0;
            XenonLampWorkTimer_1s = 0;
            XenonLampWorkTimer_Min = 0;
            R_LIGHT_WORK_HOUR = 0;
        } else {
            if (R_BRIGHTNESS_SET != 0) {
                INC_PARA_U32(XenonLampWorkTimer_1s);
                if (XenonLampWorkTimer_1s >= 60) {
                    XenonLampWorkTimer_1s = 0;
                    INC_PARA_U32(XenonLampWorkTimer_Min);
                    R_LIGHT_WORK_HOUR = XenonLampWorkTimer_Min / 60;
                }
            }
        }
    }
}
