LeoLHsu/Xenon_Lamp/Core/Src/usart.c

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
/* Includes ------------------------------------------------------------------*/
#include "usart.h"

UART_HandleTypeDef huart1;

/* USART1 init function */

void MX_USART1_UART_Init(void)
{

    huart1.Instance = USART1;
    huart1.Init.BaudRate = 115200;
    huart1.Init.WordLength = UART_WORDLENGTH_8B;
    huart1.Init.StopBits = UART_STOPBITS_1;
    huart1.Init.Parity = UART_PARITY_NONE;
    huart1.Init.Mode = UART_MODE_TX_RX;
    huart1.Init.HwFlowCtl = UART_HWCONTROL_NONE;
    huart1.Init.OverSampling = UART_OVERSAMPLING_16;
    huart1.Init.OneBitSampling = UART_ONE_BIT_SAMPLE_DISABLE;
    huart1.Init.ClockPrescaler = UART_PRESCALER_DIV1;
    huart1.AdvancedInit.AdvFeatureInit = UART_ADVFEATURE_NO_INIT;
    if (HAL_UART_Init(&huart1) != HAL_OK) {
        Error_Handler();
    }
    if (HAL_UARTEx_SetTxFifoThreshold(&huart1, UART_TXFIFO_THRESHOLD_1_8) != HAL_OK) {
        Error_Handler();
    }
    if (HAL_UARTEx_SetRxFifoThreshold(&huart1, UART_RXFIFO_THRESHOLD_1_8) != HAL_OK) {
        Error_Handler();
    }
    if (HAL_UARTEx_DisableFifoMode(&huart1) != HAL_OK) {
        Error_Handler();
    }
}

void HAL_UART_MspInit(UART_HandleTypeDef* uartHandle)
{

    GPIO_InitTypeDef GPIO_InitStruct = {0};
    RCC_PeriphCLKInitTypeDef PeriphClkInitStruct = {0};
    if (uartHandle->Instance == USART1) {
        /** Initializes the peripherals clock
        */
        PeriphClkInitStruct.PeriphClockSelection = RCC_PERIPHCLK_USART1;
        PeriphClkInitStruct.Usart16ClockSelection = RCC_USART16CLKSOURCE_D2PCLK2;
        if (HAL_RCCEx_PeriphCLKConfig(&PeriphClkInitStruct) != HAL_OK) {
            Error_Handler();
        }

        /* USART1 clock enable */
        __HAL_RCC_USART1_CLK_ENABLE();

        __HAL_RCC_GPIOA_CLK_ENABLE();
        /**USART1 GPIO Configuration
        PA9     ------> USART1_TX
        PA10     ------> USART1_RX
        */
        GPIO_InitStruct.Pin = UART_DEBUG_TX_Pin | UART_DEBUG_RX_Pin;
        GPIO_InitStruct.Mode = GPIO_MODE_AF_PP;
        GPIO_InitStruct.Pull = GPIO_NOPULL;
        GPIO_InitStruct.Speed = GPIO_SPEED_FREQ_LOW;
        GPIO_InitStruct.Alternate = GPIO_AF7_USART1;
        HAL_GPIO_Init(GPIOA, &GPIO_InitStruct);

        /* USART1 interrupt Init */
        HAL_NVIC_SetPriority(USART1_IRQn, 0, 0);
        HAL_NVIC_EnableIRQ(USART1_IRQn);
    }
}

void HAL_UART_MspDeInit(UART_HandleTypeDef* uartHandle)
{

    if (uartHandle->Instance == USART1) {
        /* Peripheral clock disable */
        __HAL_RCC_USART1_CLK_DISABLE();

        /**USART1 GPIO Configuration
        PA9     ------> USART1_TX
        PA10     ------> USART1_RX
        */
        HAL_GPIO_DeInit(GPIOA, UART_DEBUG_TX_Pin | UART_DEBUG_RX_Pin);

        /* USART1 interrupt Deinit */
        HAL_NVIC_DisableIRQ(USART1_IRQn);
    }
}

/* USER CODE BEGIN 1 */
volatile uint8_t Uart1_RxData = 0;

__weak void UART1_TxCallBack_ISR(void)
{

}

__weak void UART1_RxCallBack_ISR(uint8_t Data)
{

}

void HAL_UART_TxCpltCallback(UART_HandleTypeDef *huart)
{
    if (&huart1 == huart) {
        UART1_TxCallBack_ISR();
        HAL_UART_Receive_IT(&huart1, (uint8_t *)&Uart1_RxData, 1);
    }
}

void HAL_UART_RxCpltCallback(UART_HandleTypeDef *huart)
{
    if (&huart1 == huart) {
        UART1_RxCallBack_ISR(Uart1_RxData);
        HAL_UART_Receive_IT(&huart1, (uint8_t *)&Uart1_RxData, 1);
    }
}
/* USER CODE END 1 */
