LeoLHsu/Xenon_Lamp/Core/Src/iwdg.c

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
/* Includes ------------------------------------------------------------------*/
#include "iwdg.h"

IWDG_HandleTypeDef hiwdg1;

/* IWDG1 init function */
void MX_IWDG1_Init(void)
{

    hiwdg1.Instance = IWDG1;
    hiwdg1.Init.Prescaler = IWDG_PRESCALER_32;
    hiwdg1.Init.Window = 100;
    hiwdg1.Init.Reload = 100;
    if (HAL_IWDG_Init(&hiwdg1) != HAL_OK) {
        Error_Handler();
    }
}

/* USER CODE BEGIN 1 */
void Set_IWDG1_Timeout(uint16_t timeout_ms)
{
    if (timeout_ms > 0x0FFF) {
        timeout_ms = 0x0FFF;
    }

    hiwdg1.Instance = IWDG1;
    hiwdg1.Init.Prescaler = IWDG_PRESCALER_32;
    hiwdg1.Init.Window = timeout_ms;
    hiwdg1.Init.Reload = timeout_ms;
    if (HAL_IWDG_Init(&hiwdg1) != HAL_OK) {
        Error_Handler();
    }
}
/* USER CODE END 1 */
