LeoLHsu/Xenon_Lamp/(commit log)

2025-03-21 [feature][Xenon][All]-Added ADC service layer.
    [why]Ignore
    [how]Ignore
    [CRC]Ignore
2025-04-25 [feature][Xenon][All]-Modified the MCU to STM32H743VGT6.
    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
2025-05-09 [feature][Xenon][All]-Added bootloader and the processing of external crystal oscillator not working.
    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
    [MainRegister.c, main.c]
2025-05-23 [feature][Xenon][All]-added NTC device.
    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
2025-05-29 [feature][Xenon][All]-根据新的硬件，更新氙灯控制和反馈部分的逻辑。
    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
2025-06-06 [feature][Xenon][All]-增加服务于滤光片的推杆功能，电机驱动芯片为DRV8876。
    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
2025-06-06 [feature][Xenon][All]-增加Enable寄存器功能。
    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
2025-06-06 [feature][Xenon][All]-添加DRV8876规格书到仓库。
    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
2025-06-09 [feature][Xenon_Lamp][All]-增加Can控制器重置功能，防止因干扰、仲裁等原因导致can控制器进入Bus-Off模式，无法收发数据。
    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
2025-06-13 [feature][Xenon_Lamp][All]-增加错误周期上报逻辑。
    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
2025-06-15 [feature][Xenon_Lamp][All]-增加氙灯强制关闭功能、增加几个错误（温度相关、强制关闭相关、电机相关）。
    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
2025-06-17 [feature][Xenon_Lamp][All]-增加内部固件版本号通讯功能。
    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
2025-06-18 [bugfix][Xenon_Lamp][All]-解决ADC响应过慢、推杆上电后不复位、氙灯电流突变可能导致熄灭的问题，同时增加打印信息。
    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
    [Adc_Service.c, Debug.c, Xenon_Lamp.c, Xenon_Lamp.h]
2025-06-24 [feature][Xenon_Lamp][All]-修改氙灯电流的调制时间为5s。
    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
2025-06-24 [feature][Xenon_Lamp][All]-增加发布版本历史拉取工具。
    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
    [Xenon_Lamp_dev_Release_Version_History.csv]
2025-06-26 [feature][Xenon_Lamp][All]-添加新的bootloader和XRCoder工具，用于增加Git信息打印。
    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
2025-06-27 [fixbug][Xenon_Lamp][All]-解决氙灯点亮情况下模块失能再使能，氙灯无法二次点亮的问题。
    [why]XenonLampCtrlStep变量失能时没有重置
    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
    [Xenon_Lamp.c]
2025-07-04 [feature][Xenon_Lamp][All]-新增氙灯指示灯控制功能，氙灯正常点亮后指示灯点亮，其他情况熄灭（仅使用LAMP_LED0，LAMP_LED1为预留设计）。
    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
2025-07-04 [feature][Xenon_Lamp][All]-新增氙灯线性照度功能，由宏USE_LINEAR_ILLUMINATION控制
    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
    [两台氙灯测试数据.xlsx]
2025-07-25 [feature][Xenon_Lamp][All]-启动电流修改为12A，同时修改照度曲线
    [why]氙灯功率改为175W
    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
    [两台氙灯测试数据-175W -20250724.xlsx]
2025-08-01 [feature][Xenon_Lamp][All]-寿命报警及强制关闭、温度报警及强制关闭四个报错改为在氙灯开启时报一次。
    [why]更符合使用逻辑
    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
2025-08-14 [feature][Xenon_Lamp][All]-项目文档整理
    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
2025-08-21 [feature][Xenon_Lamp][All]-增加AppMarker相关内容并更新Boot和Coder文件
    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
    [Xenon_Lamp_dev_Release_Version_History.csv]
2025-08-22 [feature][Xenon_Lamp][All]-更新Coder文件以实现仅拉取当前Branch下Tags的功能
    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
