LeoLHsu/Xenon_Lamp/(notices)

Notices in the files:
Core/Src/adc.c:
Copyright (c) 2025 STMicroelectronics.
All rights reserved.
This software is licensed under terms that can be found in the LICENSE file
